0maru/3d-designs/README.txt

Bambu Lab スプール収納ケース — 省スペース・自立型 v2
作成日：2026-10-10

変更点
・スプールを縦にして置ける一体型の脚を追加。
・外形を約 幅222 × 高さ224 × 奥行80 mmに縮小。
・8本のつまみねじを廃止。4か所の爪とカム溝で止めるバヨネット式のふた。
・正面から見て約35度、時計回りにひねると閉じる。反時計回りで解除。
・別途必要なのはパッキンとシリカゲル小袋。金属ねじ・ナットは不要。

収納と寸法（mm）
対象スプール：外径200、幅67、中心穴55を仮定。
スプールより幅約22、高さ約24、奥行約13大きい外形。
ふた最大外径222。本体の通常部分は外径208.6、上部リム外径213。
本体の造形時外形：幅213 × 奥行219.5 × 高さ80。
ふたの造形時外形：約222 × 222 × 高さ15.6。
中央筒は外径48、内径44、上端Z=73.2。通気スリット幅1.2。
収納部内径203。スプールとの半径方向余裕1.5。
収納するスプールのクリップや突出部は上記余裕に含めない。
中心穴55は初案の仮定。実物が中央筒48より十分大きいことを確認する。

自立
下側に左右2本の平らな脚があり、前後方向の接地長80、左右の全幅88。
脚は収納部の外側にあり、本体と一緒に造形する。追加のスタンドは不要。
脚とふたの間には回転用の隙間がある。
脚を下にした組み立て済みCADは case_standing.step。
幾何学的な重心が脚の接地区域内にあることを、空の本体・空の閉じたケースで確認。
これは均一密度の形状モデルによる確認で、実物の転倒・耐久試験ではない。
開閉は横置きで行うとスプールや乾燥剤を扱いやすい。

開閉機構
4か所の爪をふた内側の入口に合わせてかぶせ、約35度回して固定する。
溝は浅い傾斜でパッキンを押さえ、終端側に小さな戻りを設けている。
ふた外周には指を掛けやすくする浅い凹凸がある。
少し押しながら逆に回すと、入口からふたを外せる。
回転中の代表7位置、および入口から引き抜く4位置でCAD干渉を検査済み。
実際の開閉トルク、爪の保持力、摩耗、パッキンの摩擦は未検証。
無理に回さず、部分試作で寸法と硬さを確認してから全体を造形する。

パッキン
シリコーンOリング：内径206 mm、線径2 mm、1本を想定。
溝中心径208、幅3.0、深さ1.3。閉じたときのふた隙間は0.2。
閉じた状態の線径方向圧縮は計算上0.5 mm、約25%。
回転途中は一時的にこれより圧縮が大きくなる。
材質・硬度と印刷誤差で開閉の固さが変わるので、必要に応じて溝寸法を調整する。
連続したOリングを使う。適切な入手性・寸法の部品を実際に選定して確認する。
継いだコードで代用する場合は継ぎ目も気密性を確認する。

乾燥剤
シリカゲルを通気性のある小袋に入れて中央筒へ収める。粉や粒を裸で入れない。
中央筒のスリットはケース内部にだけつながり、外気へは開口しない。
スプールの上下に通気用の空間を残している。
フィラメント供給口はなく、保管専用。

造形と確認
body.stl と lid.stl は造形向きで底面Z=0。
本体は底を下、ふたは外側の平面を下にして別プレートで印刷する。
どちらもA1の公称256 × 256 × 256 mm内。
本体外側の4つの爪は張り出しがあるので、必要に応じて局所サポートを使う。
ふた内部の溝にも短い張り出しがある。スライサーで層のプレビューを確認する。
パッキン面やカム接触面にはサポート痕を残さない。
開始条件の例：0.4 mmノズル、0.2 mm積層、外周5～6、上下6～8層。
上記は保証設定ではない。フィラメント、冷却、収縮、積層で結果は変わる。
STLの閉じたメッシュ、面の向き、CAD部品の干渉はvalidation.jsonを参照。

密閉性
本品は未造形の試作設計で、完全密閉・防湿性能を保証していない。
FDMの層間、壁、反り、パッキン面から漏れる可能性がある。
シリカゲルを入れて実物の湿度推移を確認し、必要なら面処理や寸法を調整する。
水密・真空容器・圧力容器としては設計していない。

ファイル
case_standing.step：脚を下にして立てた、ふたを閉じた組み立て状態。
case_assembly.step：設計座標でふたを閉じた組み立て状態。
body.step / lid.step：個別の編集用CAD。lid.stepはロック前の角度。
body.stl / lid.stl：個別の造形用モデル。
filament_case.py：build123d 0.13.0の設計スクリプト。
requirements.txt：CAD生成の依存ライブラリ。
validation.json：形状・回転経路の代表位置・重心・STLの確認結果。
preview.png：形状の確認用画像。

3Dプレビュー
本体・ふたは実際のCADから生成。スプールは参考形状。
中央筒の青色は説明用。実物では本体と一体の同じ材料。
パッキンの変形は模式表示で、応力解析の結果ではない。

参照
Bambu Lab公式フィラメント寸法（外径200、幅67）：
https://store.bblcdn.com/692bd7e1b9994c109466ffd310f5c0bc.pdf
Bambu Lab A1公式仕様：
https://us.store.bambulab.com/products/a1
build123d公式Import/Export：
https://build123d.readthedocs.io/en/latest/import_export.html

Git管理
このフォルダーをローカルGitリポジトリとして管理する。
設計スクリプト、STEP、STL、説明書、プレビュー、検証結果を同じ履歴に保存する。
変更時は設計コードと再生成したCADをまとめてコミットする。
初回保存の目印は design-v2 タグ。

変更内容の確認：git status
履歴の確認：git log --oneline
初回との差分：git diff design-v2 -- filament_case.py

Python環境、キャッシュ、作業用ファイルは管理対象から除外する。
