0maru/3d-designs/filament-drybox/cad/case_assembly.step

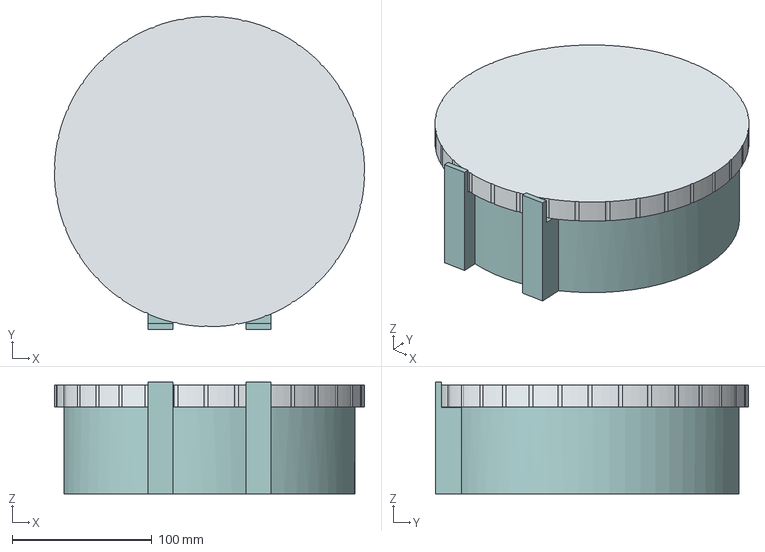
[picture p2: CAD file, 2026-10-10]
filament-drybox/cad/case_assembly.step
222.0 x 224.0 x 80.0 mm
Compact body with silica basket and integral standing feet
35 degree cam bayonet lid
