0maru/3d-designs/filament-drybox/cad/body.step

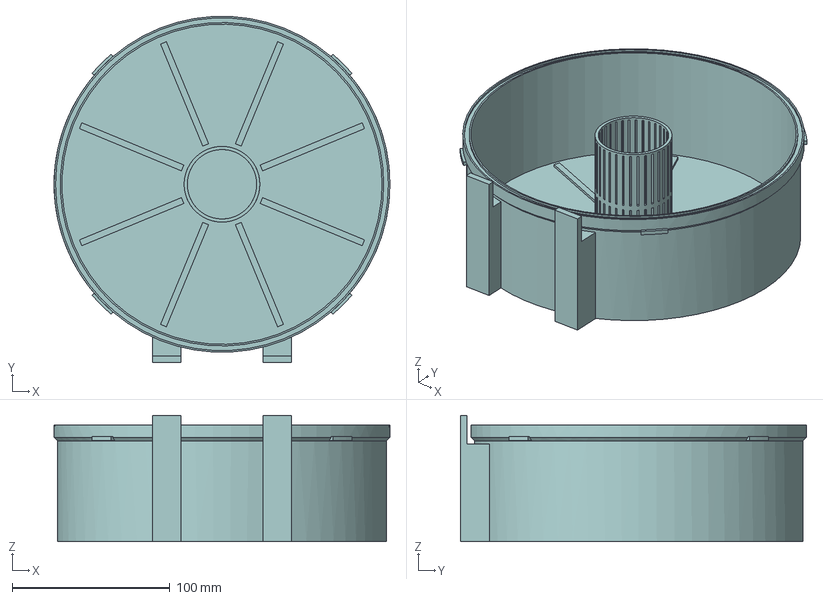
[picture p3: CAD file, 2026-10-10]
filament-drybox/cad/body.step
213.0 x 219.3 x 80.0 mm
