0maru/3d-designs/filament-drybox/cad/lid.step

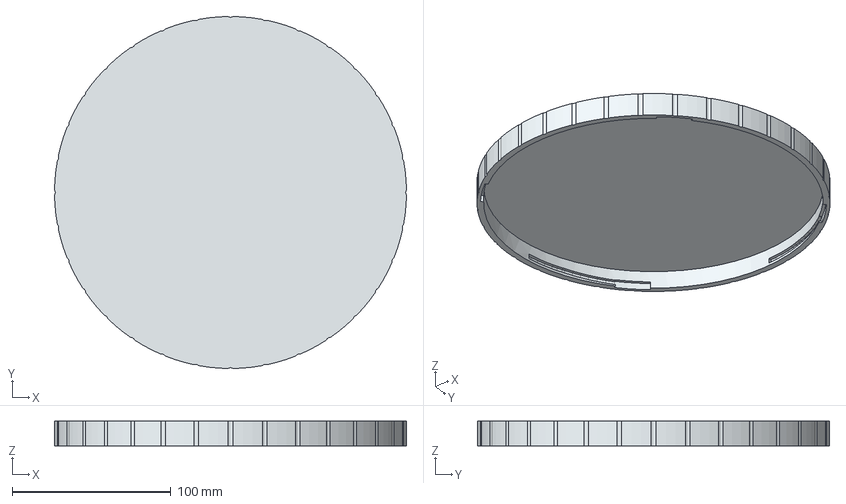
[picture p4: CAD file, 2026-10-10]
filament-drybox/cad/lid.step
222.0 x 222.0 x 15.6 mm
