0maru/3d-designs/(list of files, cad)

Other CAD files:
filament-drybox/cad/case_standing.step
filament-drybox/stl/body.stl
filament-drybox/stl/lid.stl
