0maru/3d-designs/(commit log)

2026-10-10 Add compact upright filament case design v2
    [body.step, body.stl, case_assembly.step, case_standing.step, lid.step, lid.stl]
2026-10-10 Organize CAD models under 3d-designs collection
    [body.step, body.stl, case_assembly.step, case_standing.step, lid.step, lid.stl]
